Erum330/PDE4432_Project1/1.jpg

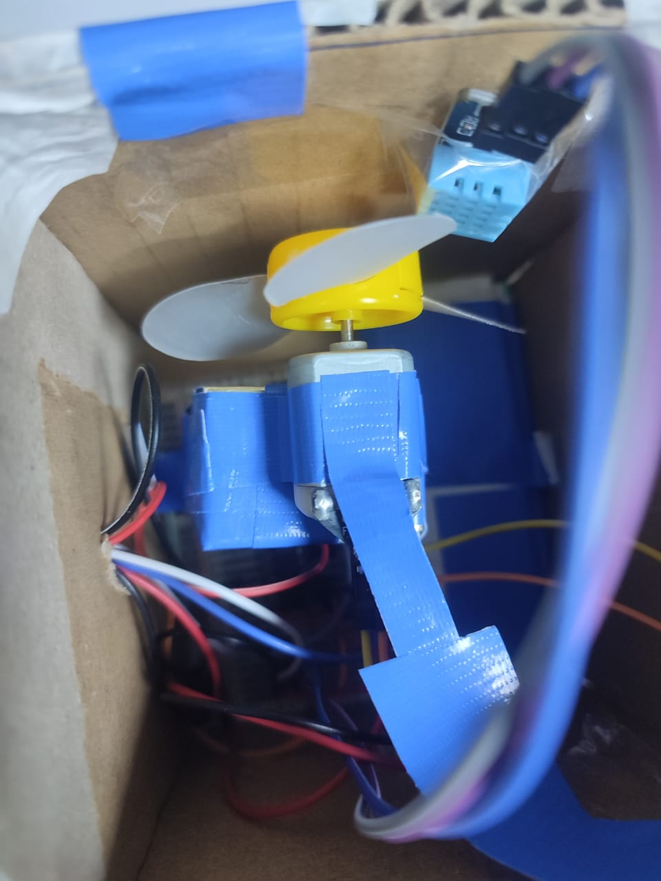
1.jpg
