Erum330/PDE4432_Project1/2.jpg

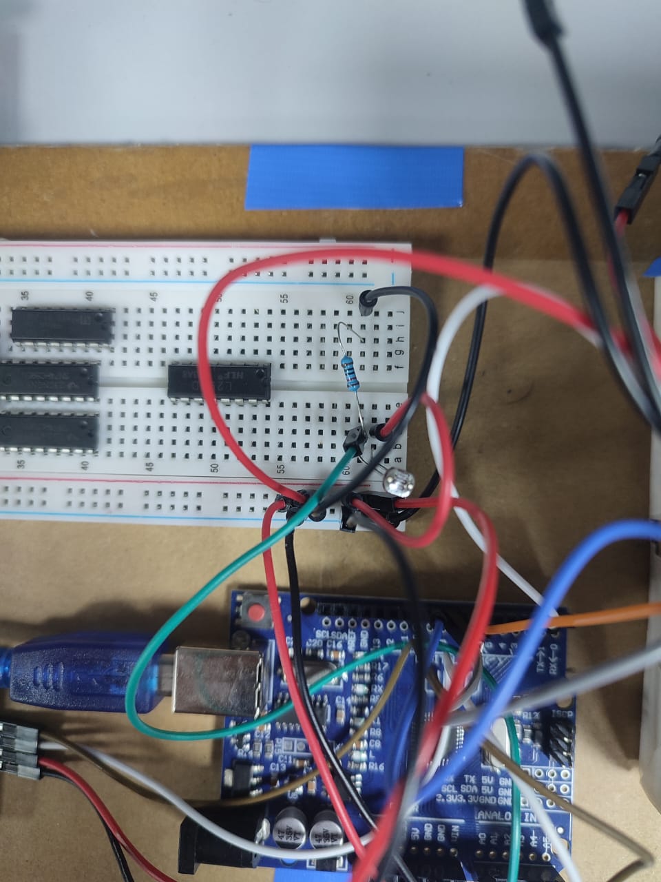
2.jpg
