Erum330/PDE4432_Project1/3.jpg

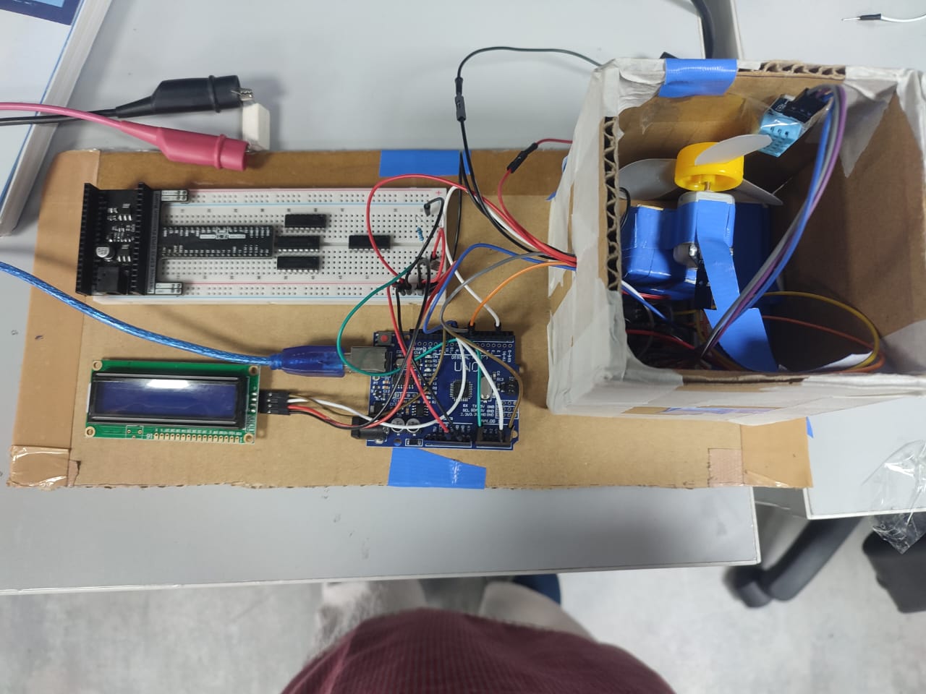
3.jpg
