Erum330/PDE4432_Project1/(commit log)

2025-10-26 Motor Testing
2025-11-02 Rename Circuit Final.drawio.png to Circuit Final.png
2025-11-02 Rename Circuit Final.png to Circuit_Final.png
